PhG22/CardForge-M1/input_cartas/20260925_152937.jpg

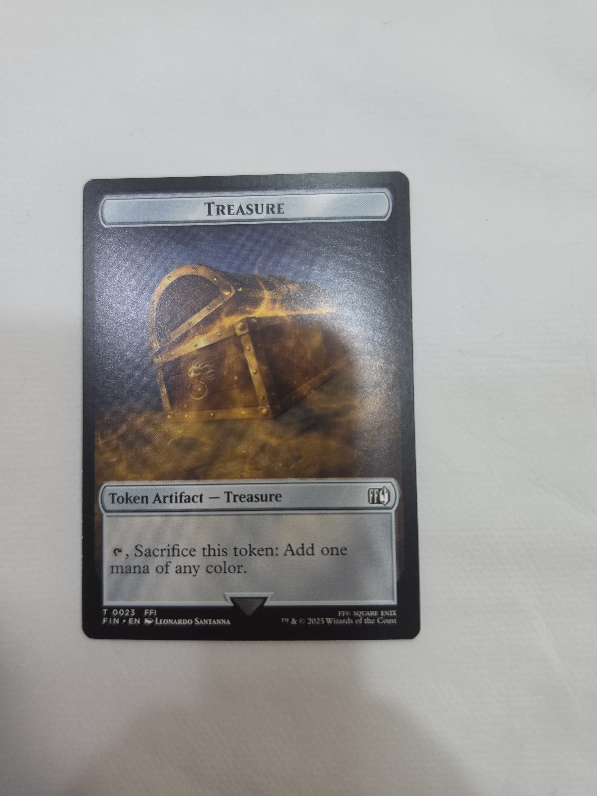
input_cartas/20260925_152937.jpg
