PhG22/CardForge-M1/input_cartas/20260925_153103.jpg

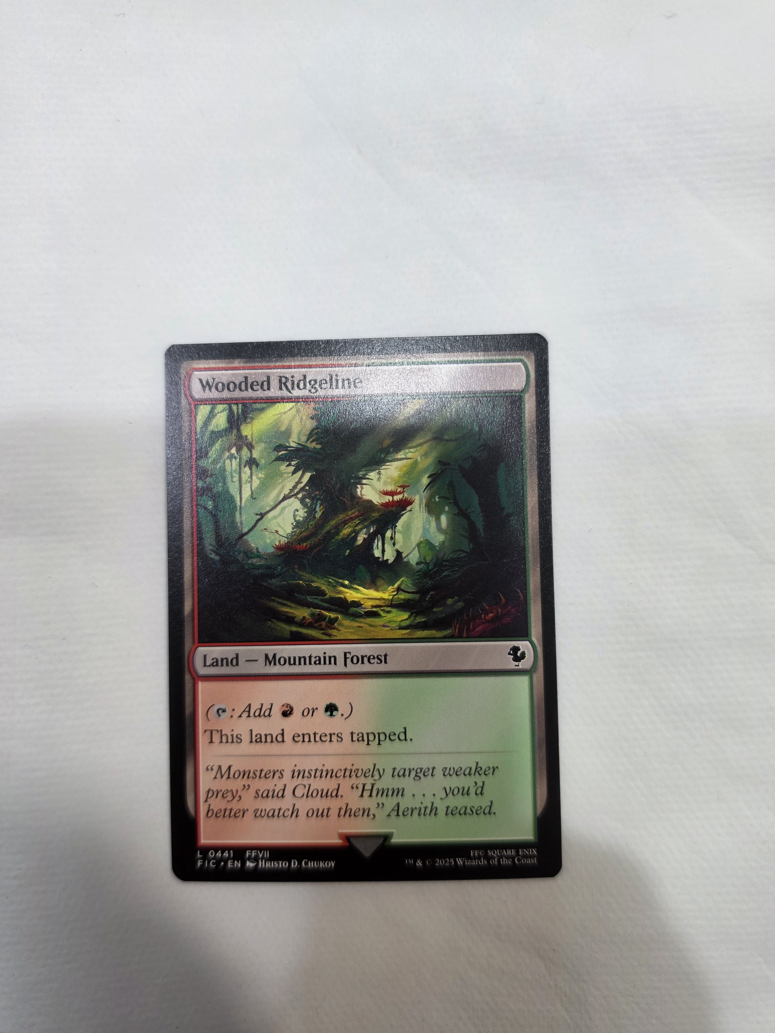
input_cartas/20260925_153103.jpg
