PhG22/CardForge-M1/input_cartas/20260925_230847.jpg

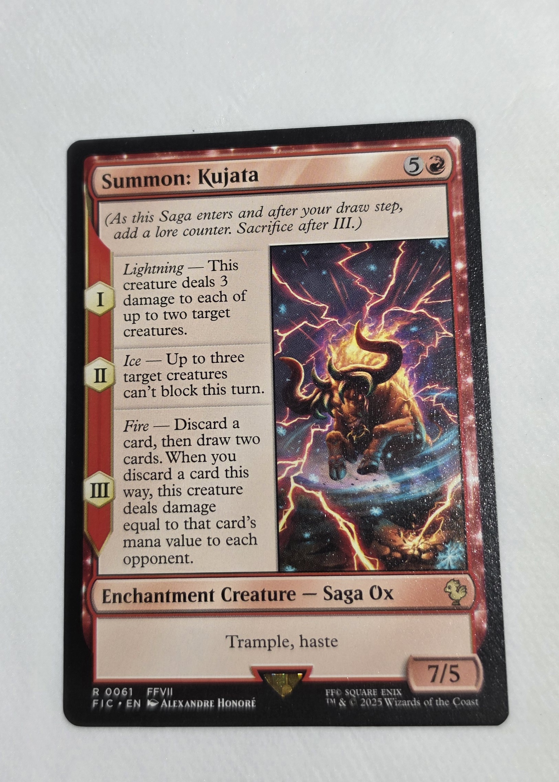
input_cartas/20260925_230847.jpg
