PhG22/CardForge-M1/input_cartas/20260927_092521.jpg

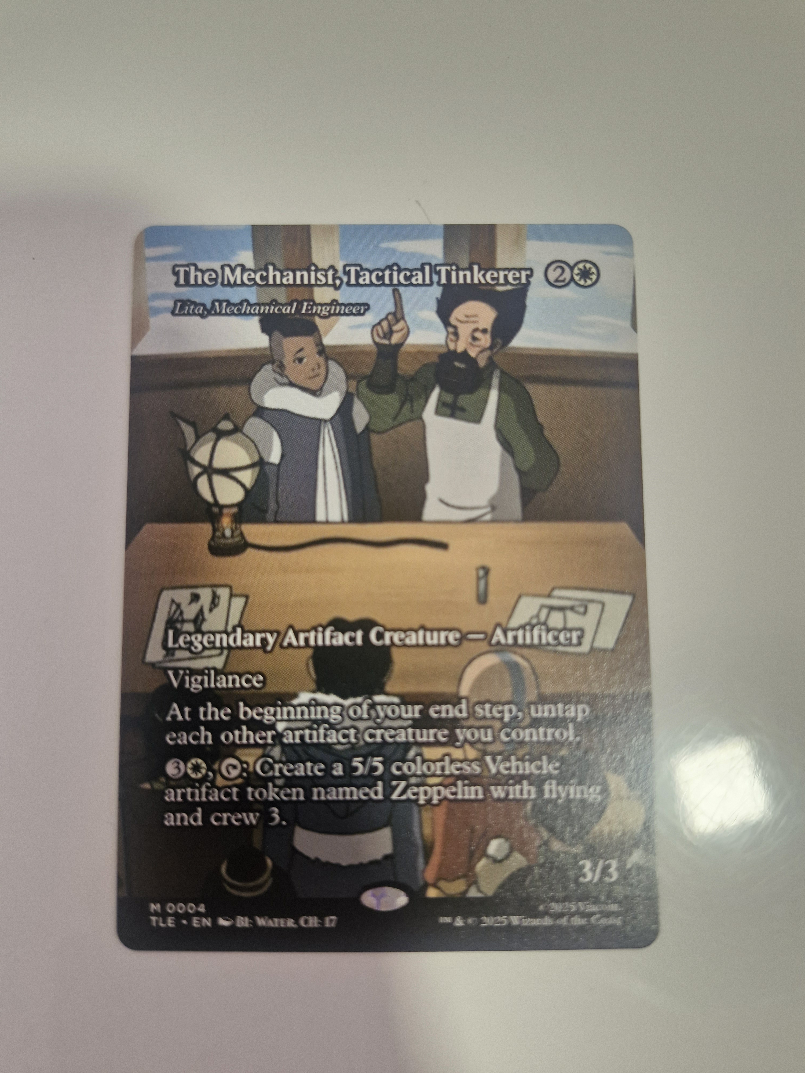
input_cartas/20260927_092521.jpg
