PhG22/CardForge-M1/relatorios/20260925_152442_processada.jpg

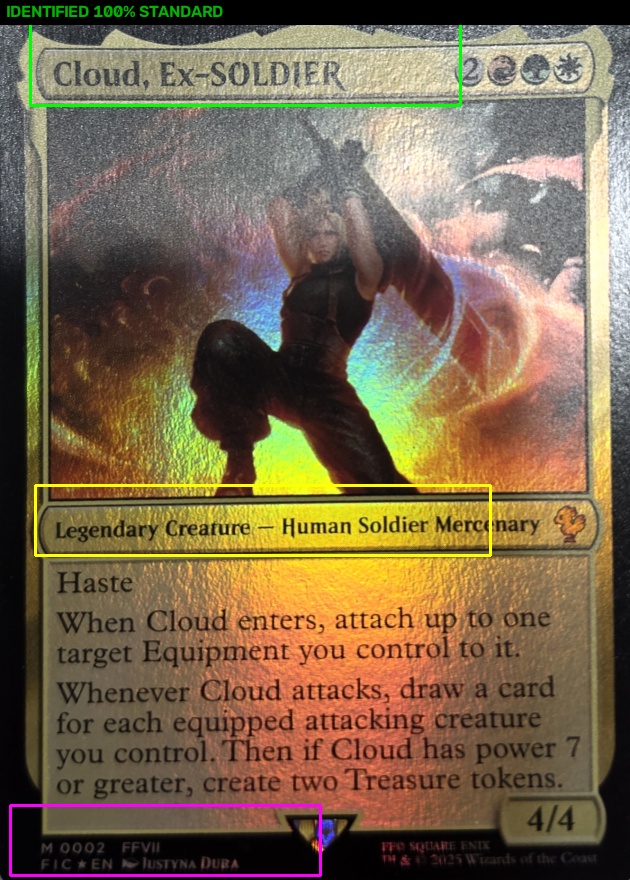
relatorios/20260925_152442_processada.jpg
