PhG22/CardForge-M1/relatorios/20260925_152524_processada.jpg

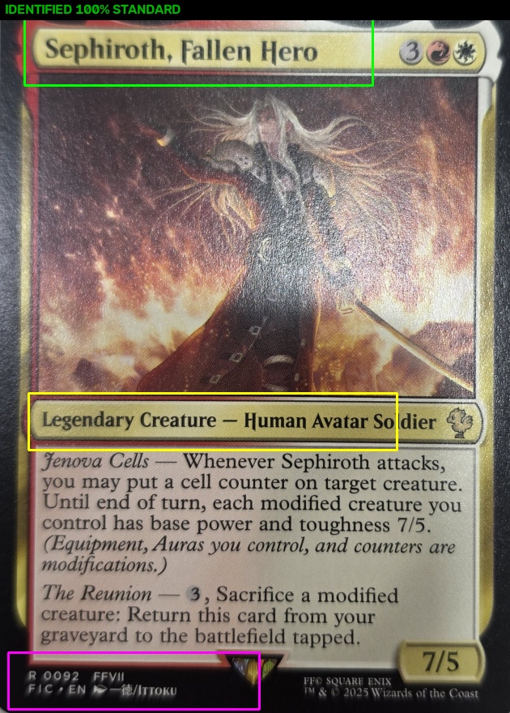
relatorios/20260925_152524_processada.jpg
