PhG22/CardForge-M1/relatorios/20260925_152959_processada.jpg

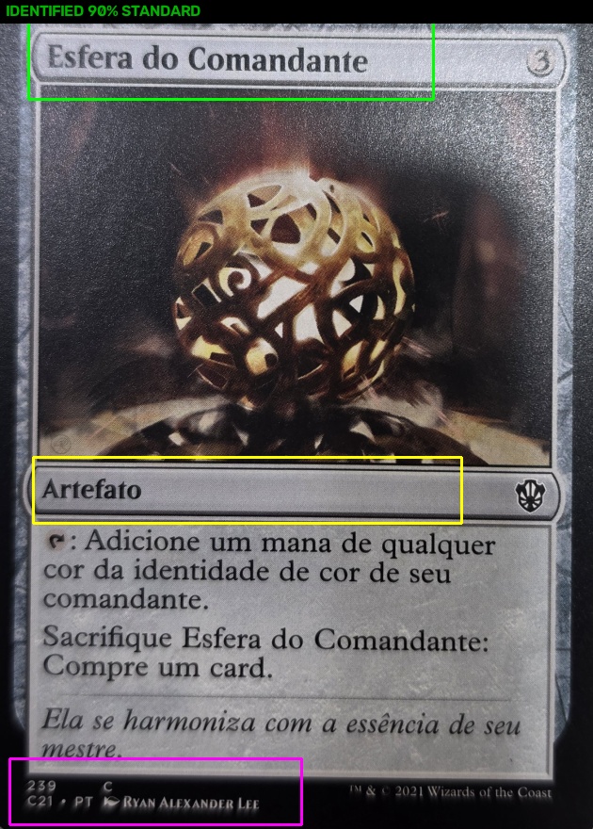
relatorios/20260925_152959_processada.jpg
