PhG22/CardForge-M1/relatorios/20260925_153542_processada.jpg

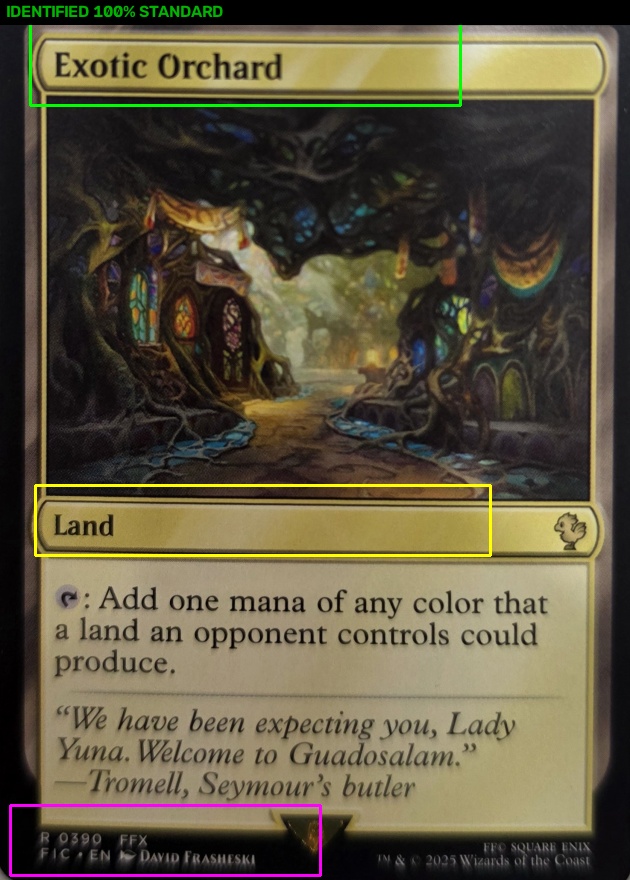
relatorios/20260925_153542_processada.jpg
