PhG22/CardForge-M1/relatorios/20260925_230528_processada.jpg

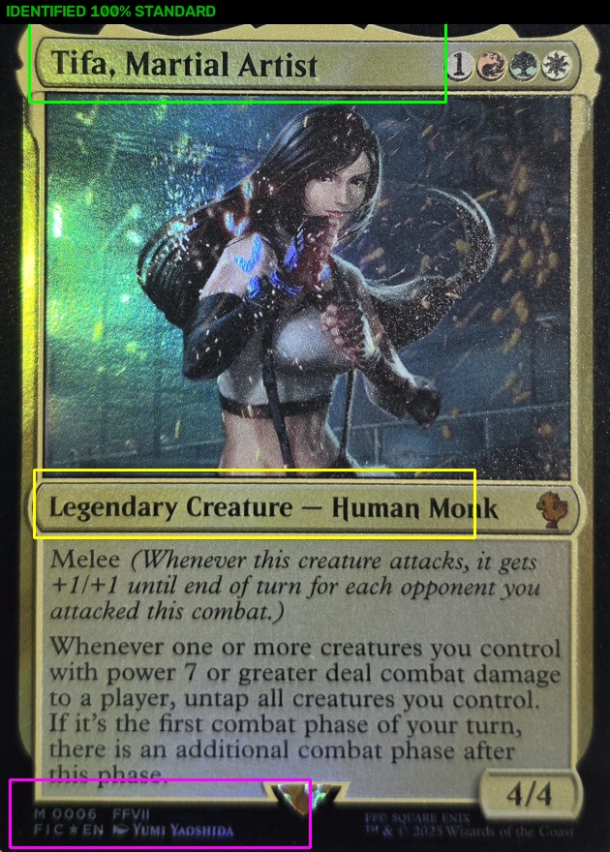
relatorios/20260925_230528_processada.jpg
