PhG22/CardForge-M1/relatorios/20260925_230637_processada.jpg

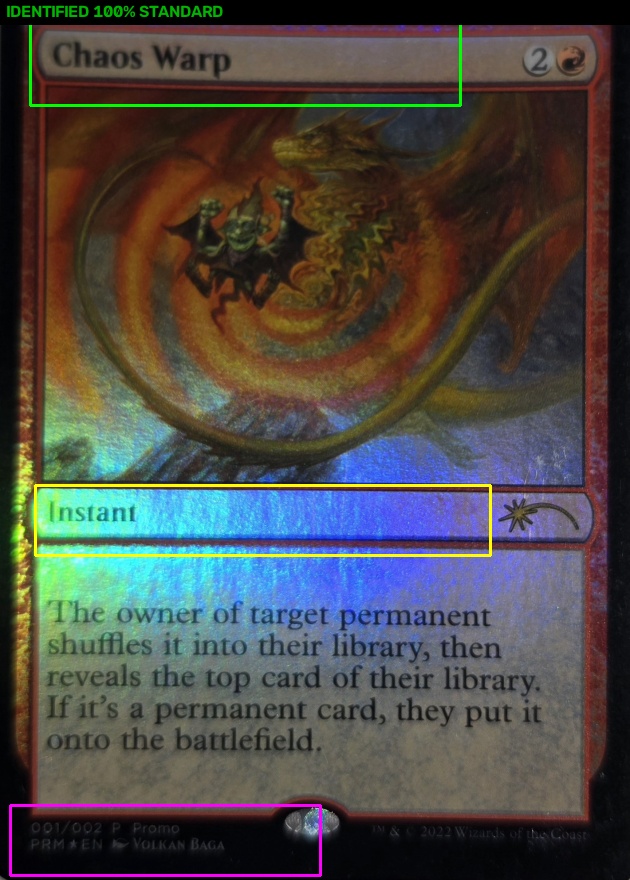
relatorios/20260925_230637_processada.jpg
