PhG22/CardForge-M1/relatorios/20260925_230715_processada.jpg

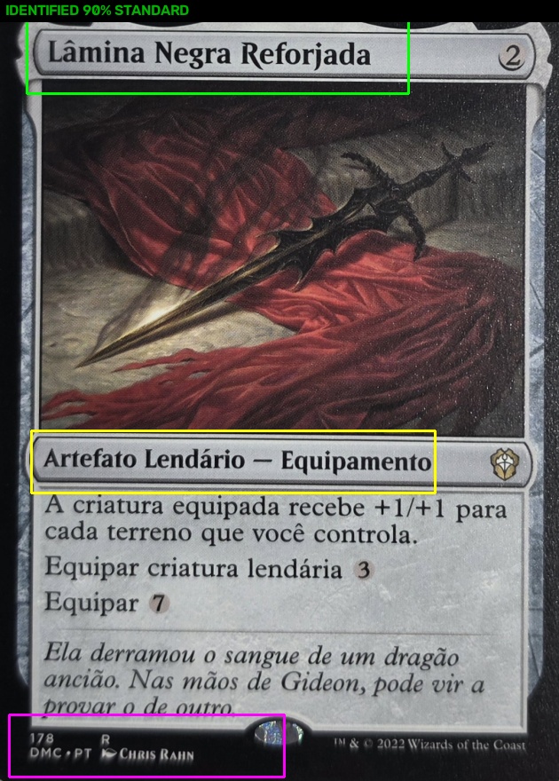
relatorios/20260925_230715_processada.jpg
