PhG22/CardForge-M1/relatorios/20260925_230815_processada.jpg

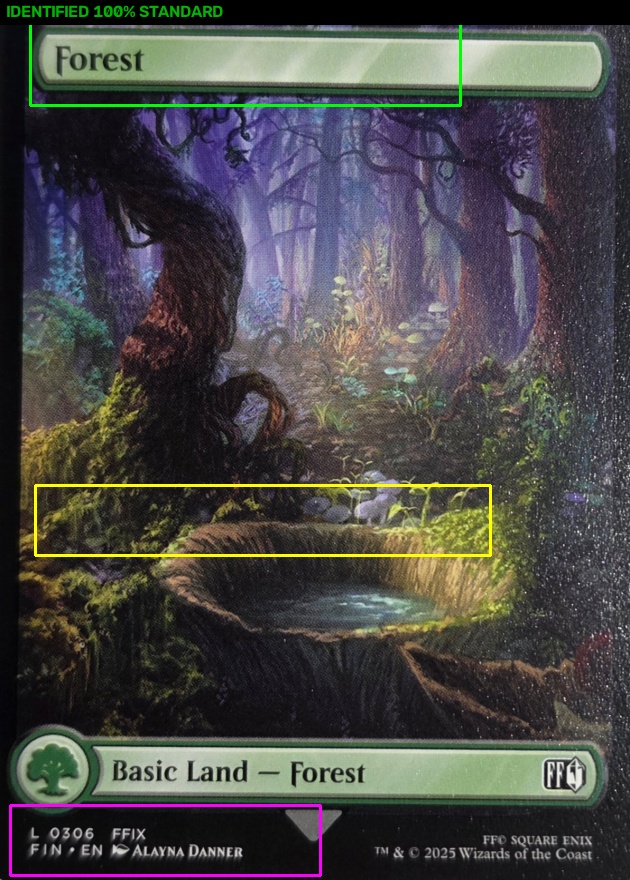
relatorios/20260925_230815_processada.jpg
