PhG22/CardForge-M1/relatorios/20260925_230847_processada.jpg

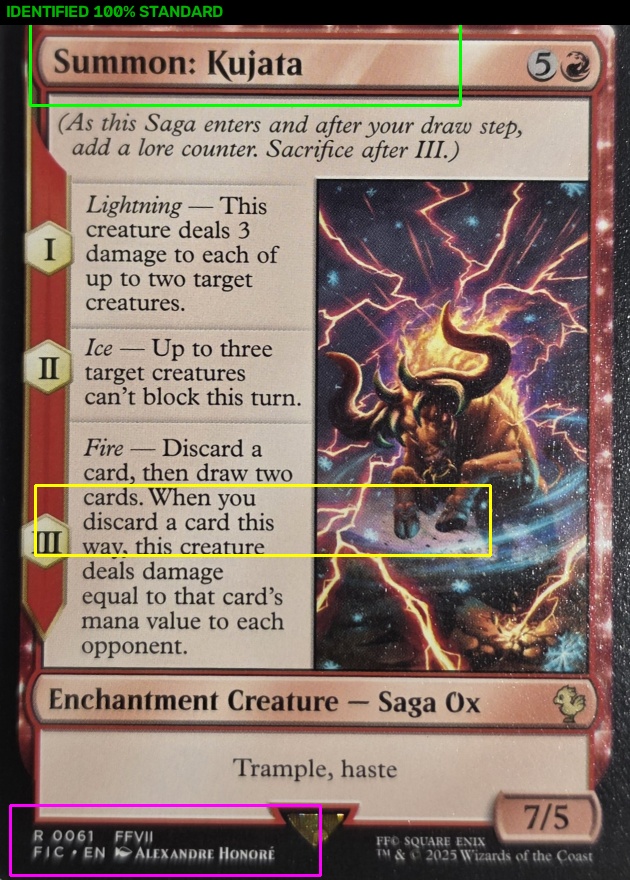
relatorios/20260925_230847_processada.jpg
