PhG22/CardForge-M1/relatorios/20260925_231020_processada.jpg

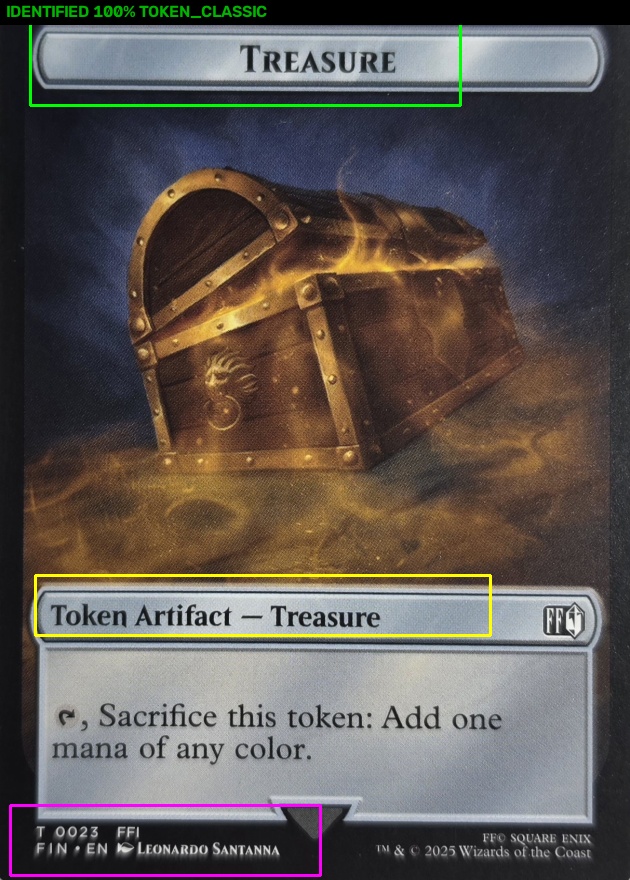
relatorios/20260925_231020_processada.jpg
