PhG22/CardForge-M1/relatorios/20260925_231043_processada.jpg

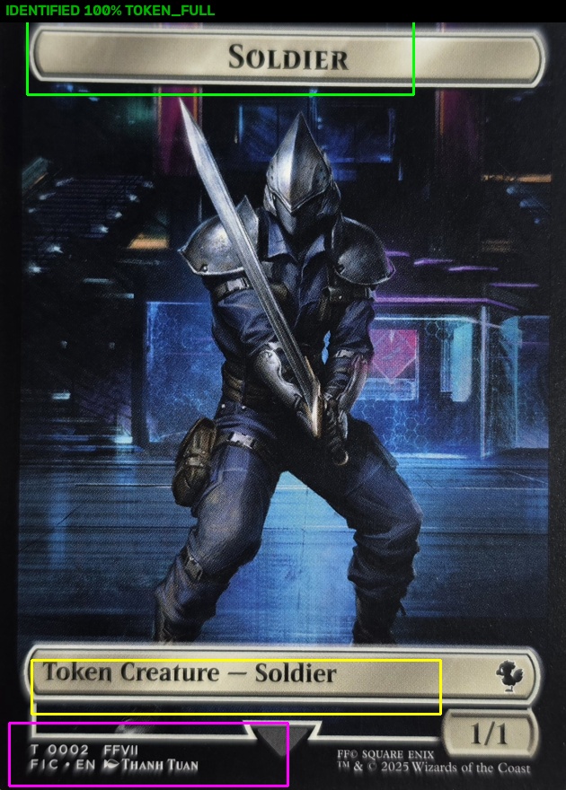
relatorios/20260925_231043_processada.jpg
