PhG22/CardForge-M1/relatorios/20260927_092518_processada.jpg

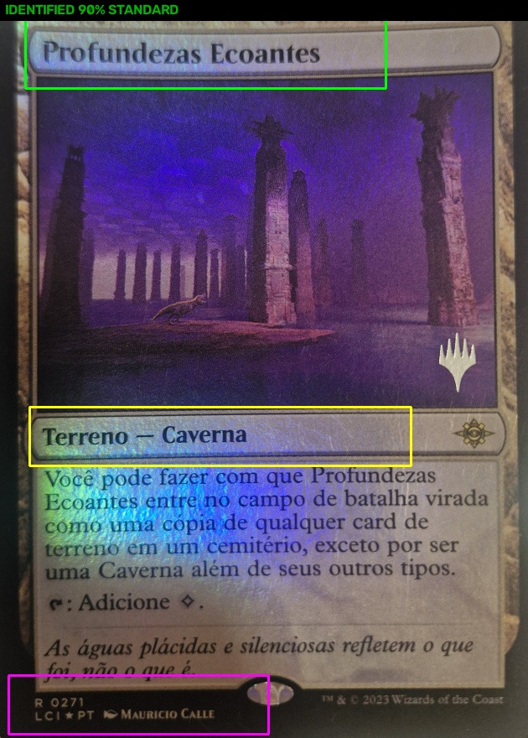
relatorios/20260927_092518_processada.jpg
