PhG22/CardForge-M1/calibragem_recorte/medicoes.csv

file | taken_at | found | strategy | corners | frame_width | frame_height
20261112_022431_334.jpg | 2026-11-12T02:24:31 | 1 | CANNY | [[0.20377, 0.3725], [0.8085, 0.34], [0.83104, 0.945], [0.20001, 0.95375]] | 1640 | 1232
20261112_022936_582.jpg | 2026-11-12T02:29:36 | 1 | CANNY | [[0.17935, 0.37], [0.81507, 0.35], [0.83385, 0.95125], [0.18593, 0.95375]] | 1640 | 1232
20261112_023028_752.jpg | 2026-11-12T02:30:28 | 1 | CANNY | [[0.20659, 0.37625], [0.80662, 0.34], [0.8301, 0.945], [0.18687, 0.95625]] | 1640 | 1232
20261112_023128_688.jpg | 2026-11-12T02:31:28 | 1 | OTSU_DARK_OPEN | [[0.20471, 0.38], [0.45167, 0.3775], [0.45918, 0.93875], [0.1878, 0.95625]] | 1640 | 1232
20261112_023209_198.jpg | 2026-11-12T02:32:09 | 1 | CANNY | [[0.20001, 0.3725], [0.80474, 0.34], [0.8301, 0.94375], [0.19626, 0.95375]] | 1640 | 1232
20261112_023339_344.jpg | 2026-11-12T02:33:39 | 1 | CANNY | [[0.17372, 0.37125], [0.8085, 0.34], [0.83198, 0.94125], [0.18593, 0.95375]] | 1640 | 1232
20261112_023410_949.jpg | 2026-11-12T02:34:10 | 1 | CANNY | [[0.20095, 0.37625], [0.80568, 0.34], [0.83385, 0.94], [0.18687, 0.96]] | 1640 | 1232
20261112_023436_276.jpg | 2026-11-12T02:34:36 | 1 | OTSU_DARK | [[0.18874, 0.3725], [0.46388, 0.3725], [0.46388, 0.95], [0.18874, 0.95]] | 1640 | 1232
20261112_023455_724.jpg | 2026-11-12T02:34:55 | 1 | OTSU_DARK | [[0.20189, 0.3725], [0.73807, 0.40875], [0.74652, 0.9375], [0.19626, 0.95125]] | 1640 | 1232
20261112_023527_295.jpg | 2026-11-12T02:35:27 | 1 | OTSU_DARK_OPEN | [[0.20565, 0.375], [0.45355, 0.37125], [0.45355, 0.95625], [0.18499, 0.95375]] | 1640 | 1232
