PhG22/CardForge-M1/relatorios/resultados.csv

file | status | confidence | method | layout | card_name | set | number | color_identity | print_id | ocr_name | ocr_type | ocr_info | ocr_set | ocr_number | elapsed_ms | verdict
20260925_152442.jpg | IDENTIFIED | 100 | SET_NUMBER | STANDARD | Cloud, Ex-SOLDIER | FIC | 2 | WRG | 07b4e4f8-6a31-4533-be51-668ce3ddc84f | Cloud,Ex-SOLDIER | Legendary CreafureHuman SoldierMerc | M0002 FFVII FIC★ENIUSTYNA DURA | FIC | 0002 | 889
20260925_152524.jpg | IDENTIFIED | 100 | SET_NUMBER | STANDARD | Sephiroth, Fallen Hero | FIC | 92 | WR | df919eb8-9eff-4777-9c46-94c795cda918 | Sephiroth,FallenHero | Legendary Creature -Human Avatar So | R0092 FFVII FIC·EN W一德/ITTOKU | FIC | 0092 | 648
20260925_152937.jpg | IDENTIFIED | 100 | SET_NUMBER | TOKEN_CLASSIC | Treasure | TFIN | 23 |  | ab0cda01-10b5-4a1b-b2bb-ad8bb296590f | TREASURE | TokenArtifact-Treasure | T0023 FFI FINEN LEONARDO SANTANNA | FIN | 0023 | 1760
20260925_152959.jpg | IDENTIFIED | 90 | SET_NUMBER_LOCALIZED | STANDARD | Commander's Sphere | C21 | 239 |  | 1c1fda5d-f519-4b27-9fc6-1a617d0fc79b | Esfera do Comandante | Artefato | 239 C21·PT RYANALEXANDERLEE | C21 | 239 | 498
20260925_153020.jpg | IDENTIFIED | 100 | SET_NUMBER | STANDARD | Tifa, Martial Artist | FIC | 6 | WRG | 31513afc-329c-4913-8fcd-945c39ec82b2 | Tifa,MartialArtist | LegendaryCreature-HumanMon | M0006 FFVII FIC*ENYUMIYAOSHIDA | FIC | 0006 | 582
20260925_153044.jpg | IDENTIFIED | 100 | SET_NUMBER | STANDARD | Bastion Protector | FIC | 233 | W | 0ed04a28-2984-4fa6-a11e-f508b7b5446e | Bastion Protector | Creature-Human Soldier | R0233 FFVII FICEN WIGNATIUSBUDI | FIC | 0233 | 502
20260925_153103.jpg | CROP_FAILED | 0 |  |  |  |  |  |  |  |  |  |  |  |  | 116
20260925_153122.jpg | IDENTIFIED | 100 | SET_NUMBER | STANDARD | Harmonize | FIC | 308 | G | 978410dd-aace-4a70-8028-6dd11c14156e | Harmonize | Sorcery | U0308 FFVII FICEN MAGALI VILLENEUVE | FIC | 0308 | 542
20260925_153154.jpg | IDENTIFIED | 100 | SET_NUMBER | STANDARD | Rugged Prairie | FIC | 417 | WR | 3d575770-cb81-4353-b49e-cdaca7a5162f | Rugged Prairie | Land | R0417 FFVII FIC.EN PABLO MENDOZA | FIC | 0417 | 497
20260925_153224.jpg | IDENTIFIED | 100 | SET_NUMBER | STANDARD | Scavenger Grounds | FIC | 419 |  | a4e3f65d-8d73-4fd1-9de4-813ba6e40940 | ScavengerGrounds | Desert | R.0419 FFXIV FICEN SALVATORREZEEYAZZIE | FIC | 0419 | 999
20260925_153246.jpg | IDENTIFIED | 100 | SET_NUMBER | STANDARD | Barret Wallace | FIN | 129 | R | 1a504dff-5857-4a61-ab99-616d5df7cf5a | BarretWallace | LegendaryCreature-Human Rel | U:0129 FFVII FINENOPATRIK HELL | FIN | 0129 | 1033
20260925_153311.jpg | IDENTIFIED | 100 | NAME_EXACT | STANDARD | Chaos Warp | MBC | 72 | R | fb8d8106-b9bd-405c-886e-72fc301c65e1 | Chaos Warp | Instant | 001/002 PPromo PRM*ENK NOLKANBAGA | PRM | 001 | 949
20260925_153333.jpg | IDENTIFIED | 100 | SET_NUMBER | STANDARD | Command Tower | FIC | 485 |  | aae0b3ae-ed57-4d17-8876-736aa22186cf | Command Tower | Land | C0485 FICENER | FIC | 0485 | 409
20260925_153353.jpg | IDENTIFIED | 100 | SET_NUMBER | STANDARD | Zack Fair | FIN | 45 | W | f21f9161-5945-40da-8da0-446f6a4a1c23 | ZackFain | Legendary Creature-Human Sole | U0045 FFVU FINEN 杉浦善夫/OSHIOSUGIURA | FIN | 0045 | 579
20260925_153422.jpg | IDENTIFIED | 100 | NAME_EXACT | STANDARD | Secret Rendezvous | FIC | 219 | W | 1fed38d0-c32c-440c-9d99-ca3b48a34791 | Secret Rendezvous | Sorcery | FIC·EN藤木幼/YUUFUKA | FIC | UNKNOWN | 376
20260925_153438.jpg | CROP_FAILED | 0 |  |  |  |  |  |  |  |  |  |  |  |  | 87
20260925_153457.jpg | IDENTIFIED | 90 | SET_NUMBER_LOCALIZED | STANDARD | Blackblade Reforged | DMC | 178 |  | 240448cd-c308-49ae-9e4b-0c35adc59fba | Lamina Negra Reforjada | Artefato Lendario-Equipamento | 178 DMC·PT WCHRISRAHN | DMC | 178 | 544
20260925_153518.jpg | IDENTIFIED | 100 | SET_NUMBER | STANDARD | Plains | FIN | 295 | W | e623b058-76d2-476b-9ee6-82807f7992c3 | Plains |  | L0295 FFVI FINEN JONASDERO | FIN | 0295 | 359
20260925_153542.jpg | IDENTIFIED | 100 | SET_NUMBER | STANDARD | Exotic Orchard | FIC | 390 |  | 47c2b572-b54a-444c-8d74-b005e94d751f | ExoticOrchard | Land | R0390 FFX FICIEN DAYID FRASHESKI | FIC | 0390 | 482
20260925_153603.jpg | CROP_FAILED | 0 |  |  |  |  |  |  |  |  |  |  |  |  | 109
20260925_153619.jpg | IDENTIFIED | 100 | NAME_EXACT | FULL_ART | Forest | FIN | 576 | G | 2036f825-ef57-4a40-b45f-0668d9c8ec6a | Forest | BasicLand-Forest | L9306 FIN.EN FFIX ALAYNADANNER | FIN | 9306 | 1091
20260925_153644.jpg | CROP_FAILED | 0 |  |  |  |  |  |  |  |  |  |  |  |  | 110
20260925_153646.jpg | IDENTIFIED | 90 | SET_NUMBER_LOCALIZED | STANDARD | Summon: Kujata | FIC | 61 | R | ba934866-efd0-4126-b1ff-9c7e82b73bd6 | fter Sum and aj Sacrifice af thisSaga enters unter | cards. discard a card this waythiscreature | R0061 FFVI HONORE FICEN ALEXANDRE | FIC | 0061 | 656
20260925_153715.jpg | IDENTIFIED | 100 | SET_NUMBER | STANDARD | Rootbound Crag | FIC | 416 | RG | 73a2e070-f375-4558-a982-01f6f4e902e9 | Rootbound Crag | Land | R0416 FIC AEN | FIC | 0416 | 379
20260925_153807.jpg | IDENTIFIED | 100 | SET_NUMBER | STANDARD | Secret Rendezvous | FIC | 253 | W | d09a77e7-649c-4f2c-bcd3-0598271e9373 | Secret Rendezvous | Sorcery | U0253 FFVII FIC·EN 藤木/YUFkI | FIC | 0253 | 525
20260925_153819.jpg | IDENTIFIED | 90 | SET_NUMBER_LOCALIZED | STANDARD | Commander's Sphere | C21 | 239 |  | 1c1fda5d-f519-4b27-9fc6-1a617d0fc79b | Esfera do Comandante | Artefato | 239 C21·PT RYANALEXANDERLEE | C21 | 239 | 509
20260925_153835.jpg | IDENTIFIED | 100 | SET_NUMBER | STANDARD | Sephiroth, Fallen Hero | FIC | 92 | WR | df919eb8-9eff-4777-9c46-94c795cda918 | Sephiroth,FallenHero | LegendaryCreature-HumanAvatarSo | R0092 FFVII FIC·EN | FIC | 0092 | 699
20260925_153854.jpg | IDENTIFIED | 100 | SET_NUMBER | STANDARD | Cloud, Ex-SOLDIER | FIC | 2 | WRG | 07b4e4f8-6a31-4533-be51-668ce3ddc84f | Cloud,Ex-SOLDIER | LegendaryCreature-Human Soldier Merce | M0002 FFVII FICENWIUSTYNADURA | FIC | 0002 | 678
20260925_230006.jpg | IDENTIFIED | 100 | SET_NUMBER | STANDARD | Cloud, Ex-SOLDIER | FIC | 2 | WRG | 07b4e4f8-6a31-4533-be51-668ce3ddc84f | Cloud,Ex-SOLDIER | Legendary Creature-Human Soldier Merce | M0002 FFVII FIC★ENIUSTYNADURA | FIC | 0002 | 649
20260925_230528.jpg | IDENTIFIED | 100 | SET_NUMBER | STANDARD | Tifa, Martial Artist | FIC | 6 | WRG | 31513afc-329c-4913-8fcd-945c39ec82b2 | Tifa,MartialArtist | Legendary Creature -Human Mon | M0006 FFVII FIC★EN DYUMIYAOSHIDA | FIC | 0006 | 633
20260925_230601.jpg | IDENTIFIED | 90 | SET_NUMBER_LOCALIZED | STANDARD | Commander's Sphere | C21 | 239 |  | 1c1fda5d-f519-4b27-9fc6-1a617d0fc79b | Esfera do Comandante | Artefato | 239 C21.PTD RYANALEXANDERLEE | C21 | 239 | 484
20260925_230637.jpg | IDENTIFIED | 100 | NAME_EXACT | STANDARD | Chaos Warp | MBC | 72 | R | fb8d8106-b9bd-405c-886e-72fc301c65e1 | Chaos Warp | Instant | 001/002P Promo PRM*ENVOLKANBAGA | PRM | 001 | 1048
20260925_230715.jpg | IDENTIFIED | 90 | SET_NUMBER_LOCALIZED | STANDARD | Blackblade Reforged | DMC | 178 |  | 240448cd-c308-49ae-9e4b-0c35adc59fba | Lamina Negra Reforjada | Artefato Lendario -Equipamento | 178 DMC·PT WCHRISRAHN | DMC | 178 | 640
20260925_230748.jpg | IDENTIFIED | 100 | SET_NUMBER | STANDARD | Ultimate Magic: Meteor | FIC | 121 | R | 809276a9-4804-422f-abb0-ba302f329e6e | Ultimate Magic:Meteor | Sorcery | RO121 FFVII FICENASHLEYMACKENZIE | FIC | 121 | 570
20260925_230815.jpg | IDENTIFIED | 100 | SET_NUMBER | STANDARD | Forest | FIN | 306 | G | be72862d-d71e-4b18-98a6-59019399f631 | Forest |  | L0306 FFIX FINEN ALAYNADANNER | FIN | 0306 | 482
20260925_230847.jpg | IDENTIFIED | 100 | SET_NUMBER | STANDARD | Summon: Kujata | FIC | 61 | R | ba934866-efd0-4126-b1ff-9c7e82b73bd6 | Summon:Kujata | cards.When you discard a card this way,this creature | R0061 FFVII FICEN WALEXANDRE HONORE | FIC | 0061 | 636
20260925_230912.jpg | IDENTIFIED | 100 | SET_NUMBER | STANDARD | Sephiroth, Fallen Hero | FIC | 92 | WR | df919eb8-9eff-4777-9c46-94c795cda918 | Sephiroth,Fallen Hero | LegendaryCreature-Human Avatar So | R0092 FFVII FICIEN 德/ITTOKU | FIC | 0092 | 370
20260925_230944.jpg | IDENTIFIED | 100 | SET_NUMBER | TOKEN_FULL | Rebel | TFIC | 7 | R | 6afbbdad-aeed-428a-b840-c33f59a18d0b | REBEL | Token Creature-Rebel | T0007 FFVII FIC·EN ANTHONY DEVINE | FIC | 0007 | 1126
20260925_230956.jpg | IDENTIFIED | 100 | SET_NUMBER | TOKEN_FULL | Rebel | TFIC | 7 | R | 6afbbdad-aeed-428a-b840-c33f59a18d0b | REBEL | Token Creature-Rebel | T 0007 FFVII FIC·EN ANTHONY DEVINE | FIC | 0007 | 1101
20260925_231020.jpg | IDENTIFIED | 100 | SET_NUMBER | TOKEN_CLASSIC | Treasure | TFIN | 23 |  | ab0cda01-10b5-4a1b-b2bb-ad8bb296590f | TREASURE | TokenArtifact-Treasure | T0023 FFI FIN·EN LEONARDO SANTANNA | FIN | 0023 | 1426
20260925_231043.jpg | IDENTIFIED | 100 | SET_NUMBER | TOKEN_FULL | Soldier | TFIC | 2 | W | c459f2ec-2aa3-44f6-999f-b1467dd4e27c | SOLDIER | Token Creature-Soldier | T0002 FFVII FIC·EN THANHTUAN | FIC | 0002 | 1174
20260927_092411.jpg | LOW_CONFIDENCE | 89 | SET_NUMBER_NAME_MISMATCH | STANDARD | Cloudpiercer | IKO | 291 | R | 3db7d906-1794-40eb-9d73-1f2a4db3a13f | Furanuvem |  | 291 IKO·PT STEVEELLIS | IKO | 291 | 930
20260927_092415.jpg | IDENTIFIED | 90 | SET_NUMBER_LOCALIZED | STANDARD | Prickly Marmoset | IKO | 129 | R | bad8512f-31b9-48ba-bb10-1497303dcfba | Sagui Espinhoso | Criatura-Macaco | 129/274 IKOPT SIMONDOMINIC | IKO | 129 | 507
20260927_092417.jpg | IDENTIFIED | 90 | SET_NUMBER_LOCALIZED | STANDARD | Echoing Deeps | LCI | 271 |  | 244c06b3-532d-426e-8bee-ee9461d092a6 | Profundezas Ecoantes | Terreno-Caverna | R0271 LCI*PT OMAURICIOCALLE | LCI | 0271 | 466
20260927_092422.jpg | IDENTIFIED | 94 | SET_NUMBER | STANDARD | Lita, Mechanical Engineer | TLE | 4 | W | e9211079-9499-4443-8cb9-4c2bb2849994 | TheMechanist,TacticalTinke | LegendaryArtifact Creature-Arti | M0004 TLEENBI:WATER,CH:17 | TLE | 0004 | 468
20260927_092425.jpg | IDENTIFIED | 100 | SET_NUMBER | STANDARD | Lasyd Prowler | TDM | 149 | G | c7f5c8ef-8e9e-4264-a7d2-126a30a5d341 | Lasyd Prowler | Creature-Snake Ranger | R0149 TDM·EN ANNAPAVLEEVA | TDM | 0149 | 465
20260927_092427.jpg | IDENTIFIED | 90 | SET_NUMBER_LOCALIZED | STANDARD | Plains | MOM | 277 | W | 00bf269d-aca3-494c-8777-de90ae903af2 | Planicie | Terreno Basico-Planicie | L0277 MOM★PTSAMBURLEY | MOM | 0277 | 445
20260927_092429.jpg | IDENTIFIED | 100 | NAME_EXACT | STANDARD | Island | MDD | 294 | U | 1335d293-3dd2-4f13-bd2c-22181f4528ee | Island | BasicLand-Island | -JonasDeRo rv&2013WizardsoftheCoast236/249 | N/A | 236 | 519
20260927_092432.jpg | IDENTIFIED | 100 | SET_NUMBER | STANDARD | Forest | BRO | 287 | G | c1c2a41c-e974-4c14-8d01-d278ecdb31bc | Floresta |  | 287/287L BRO.PTPIOTRDUBA | BRO | 287 | 369
20260927_092434.jpg | IDENTIFIED | 100 | NAME_EXACT | STANDARD | Sakura-Tribe Elder | SOC | 285 | G | 7a8b1c49-8594-426d-b585-41140235bb0e | Sakura-Tribe Elder |  | P oooi Promo PRMEN VICTORADAMEMINGUEZ | PRM | UNKNOWN | 473
20260927_092436.jpg | IDENTIFIED | 90 | SET_NUMBER_LOCALIZED | STANDARD | Glowstone Recluse | IKO | 156 | G | 06a9698d-400c-4c31-82cd-28d0897fe28c | Aranha-violino do Lumino | CriaturaAranha | 156/274U JKOPT KYIONG-HAO HAN | IKO | 156 | 767
20260927_092438.jpg | IDENTIFIED | 100 | SET_NUMBER | STANDARD | Moonshae Pixie // Pixie Dust | CLB | 84 | U | 63780e4a-3f63-473c-97d0-5d9462e264f2 | MoonshaePixie | Creature-Faerie | 084/361U CLB·EN EDGAR SANCHEZ HIDALGO | CLB | 084 | 498
20260927_092444.jpg | IDENTIFIED | 100 | SET_NUMBER | STANDARD | Moonshae Pixie // Pixie Dust | CLB | 84 | U | 63780e4a-3f63-473c-97d0-5d9462e264f2 | Moonshae Pixie | Creature-Faerie | 084/361U CLBEN EDGAR SANCHEZ HIDALGO | CLB | 084 | 521
20260927_092447.jpg | IDENTIFIED | 100 | NAME_EXACT | STANDARD | Sakura-Tribe Elder | SOC | 285 | G | 7a8b1c49-8594-426d-b585-41140235bb0e | Sakura-TribeElder |  | P0001 Promo PRM★EN VICTORADAMEMINGUEZ | PRM | 0001 | 710
20260927_092449.jpg | IDENTIFIED | 100 | SET_NUMBER | STANDARD | Forest | BRO | 287 | G | c1c2a41c-e974-4c14-8d01-d278ecdb31bc | Floresta |  | 287/287L BRO'PT PIOTR DURA | BRO | 287 | 377
20260927_092451.jpg | LOW_CONFIDENCE | 0 | NONE | STANDARD |  |  |  |  |  | narc Toda Alcar | frer |  | N/A | UNKNOWN | 839
20260927_092458.jpg | LOW_CONFIDENCE | 89 | SET_NUMBER_NAME_MISMATCH | STANDARD | Cloudpiercer | IKO | 291 | R | 3db7d906-1794-40eb-9d73-1f2a4db3a13f | Furanuvem |  | 291 IKO·PT OSTEVEELLIS | IKO | 291 | 982
20260927_092508.jpg | IDENTIFIED | 100 | NAME_EXACT | STANDARD | Island | MDD | 294 | U | 1335d293-3dd2-4f13-bd2c-22181f4528ee | Island | BasicLand-Island | JonasDeRo m&2013WizardsoftheCoast236/249 | N/A | 236 | 541
20260927_092511.jpg | IDENTIFIED | 90 | SET_NUMBER_LOCALIZED | STANDARD | Plains | MOM | 277 | W | 00bf269d-aca3-494c-8777-de90ae903af2 | Planicie | Terreno Basico -Planicie | L0277 MOM★PTOSAMBURLEY | MOM | 0277 | 446
20260927_092513.jpg | IDENTIFIED | 100 | SET_NUMBER | STANDARD | Lasyd Prowler | TDM | 149 | G | c7f5c8ef-8e9e-4264-a7d2-126a30a5d341 | LasydProwler | Creature-Snake Ranger | R0149 TDM·EN ICANNAPAVLEEVA | TDM | 0149 | 468
20260927_092516.jpg | IDENTIFIED | 90 | SET_NUMBER_LOCALIZED | STANDARD | Prickly Marmoset | IKO | 129 | R | bad8512f-31b9-48ba-bb10-1497303dcfba | Sagui Espinhoso | Criatura-Macaco | 129/274C IKO·PT OSIMONDOMINIC | IKO | 129 | 456
20260927_092518.jpg | IDENTIFIED | 90 | SET_NUMBER_LOCALIZED | STANDARD | Echoing Deeps | LCI | 271 |  | 244c06b3-532d-426e-8bee-ee9461d092a6 | ProfundezasEcoantes | Terreno-Caverna | R0271 LCI★PT MAURICIOCALLE | LCI | 0271 | 467
20260927_092521.jpg | IDENTIFIED | 100 | SET_NUMBER | STANDARD | Lita, Mechanical Engineer | TLE | 4 | W | e9211079-9499-4443-8cb9-4c2bb2849994 |  | scnuaryArtifactCreature-A Vigilance | M0004 TLEENBI:WATERCHIZ | TLE | 0004 | 281
