PhG22/CardForge-M1/calibragem_recorte/20261112_022431_334.jpg

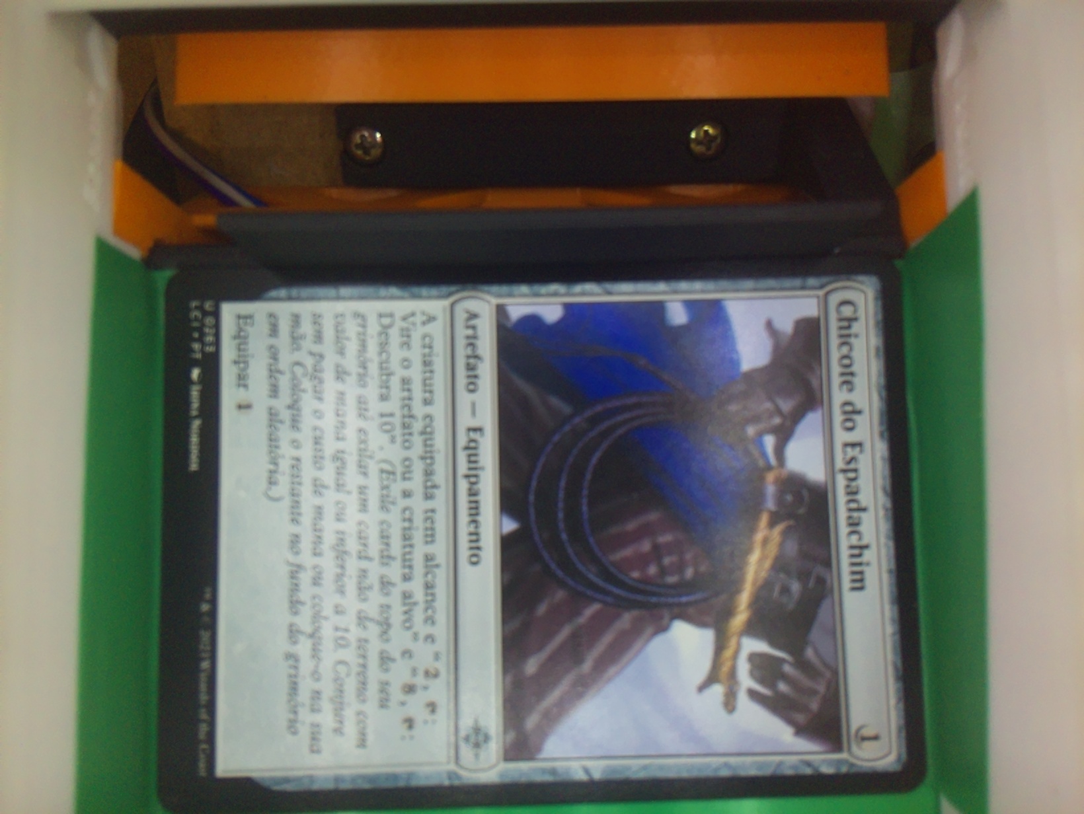
calibragem_recorte/20261112_022431_334.jpg
