PhG22/CardForge-M1/calibragem_recorte/20261112_022936_582.jpg

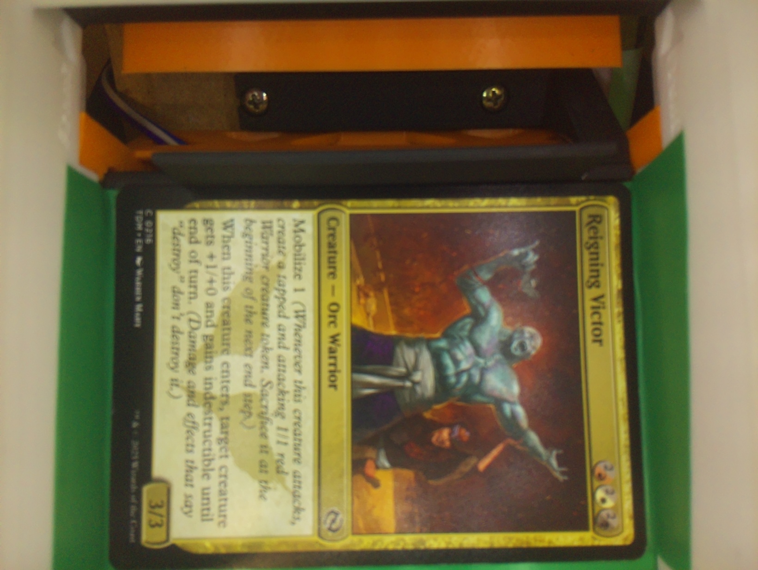
calibragem_recorte/20261112_022936_582.jpg
