PhG22/CardForge-M1/calibragem_recorte/20261112_023028_752.jpg

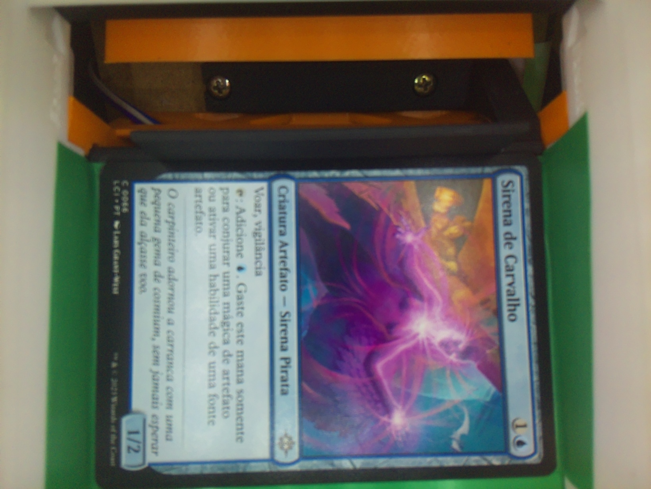
calibragem_recorte/20261112_023028_752.jpg
