PhG22/CardForge-M1/calibragem_recorte/20261112_023128_688.jpg

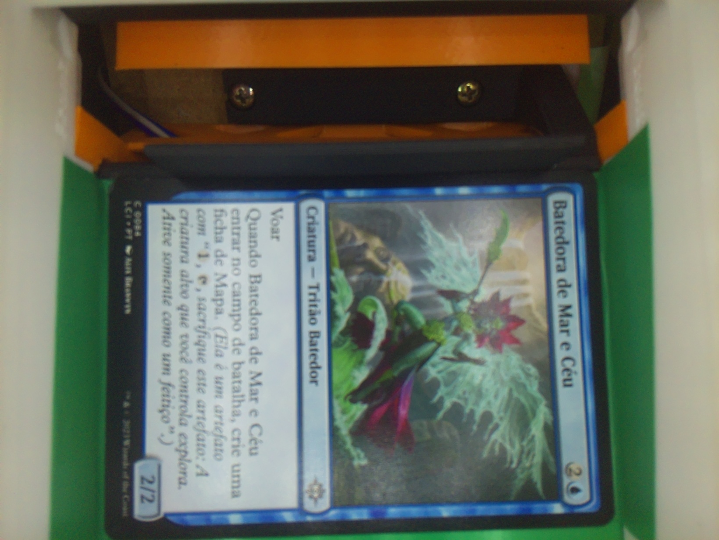
calibragem_recorte/20261112_023128_688.jpg
