PhG22/CardForge-M1/calibragem_recorte/20261112_023209_198.jpg

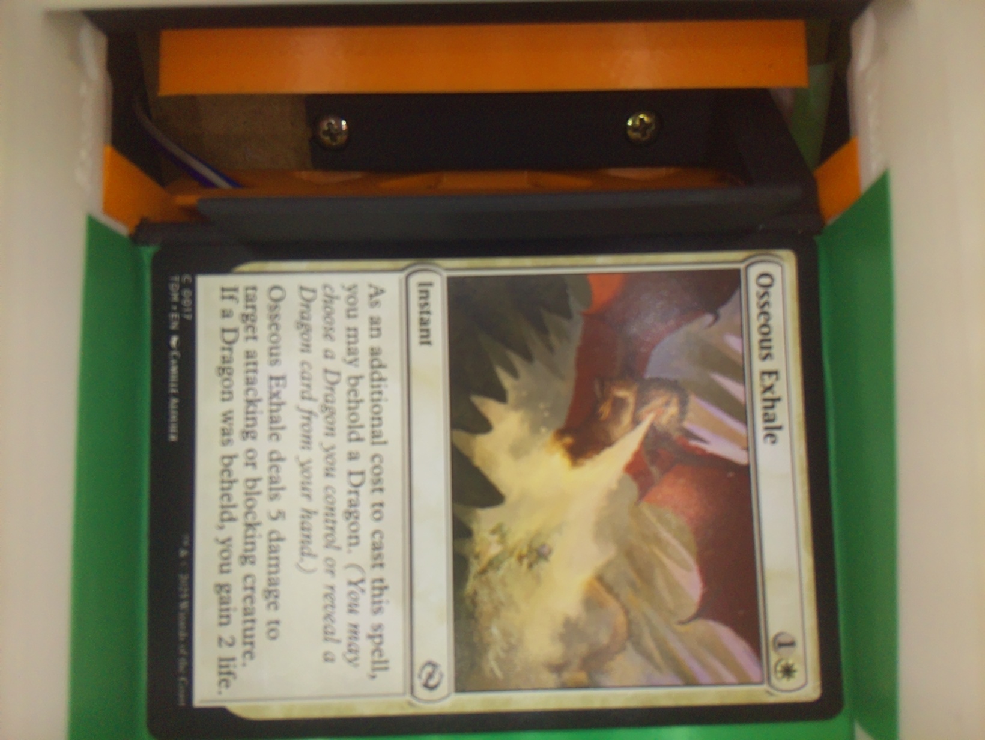
calibragem_recorte/20261112_023209_198.jpg
