PhG22/CardForge-M1/calibragem_recorte/20261112_023410_949.jpg

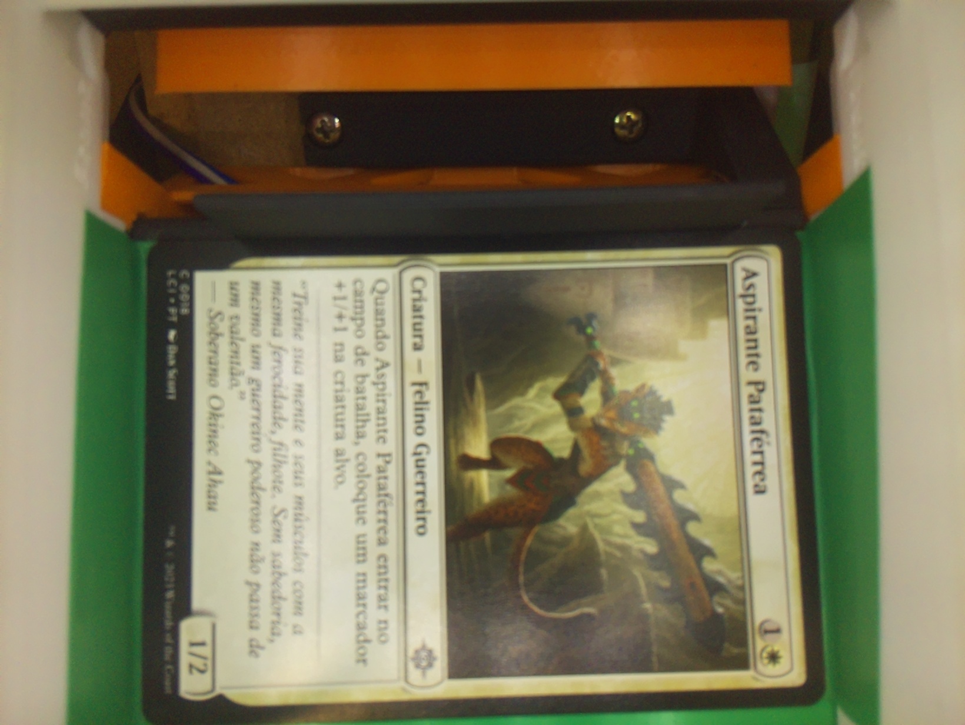
calibragem_recorte/20261112_023410_949.jpg
