PhG22/CardForge-M1/calibragem_recorte/20261112_023436_276.jpg

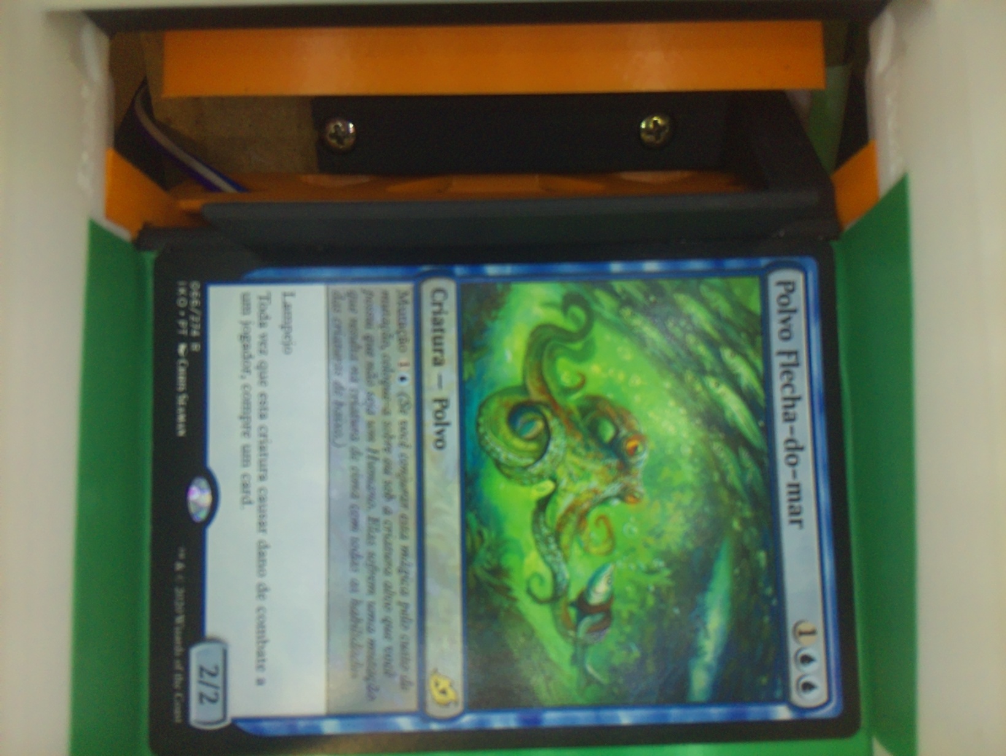
calibragem_recorte/20261112_023436_276.jpg
