PhG22/CardForge-M1/calibragem_recorte/20261112_023455_724.jpg

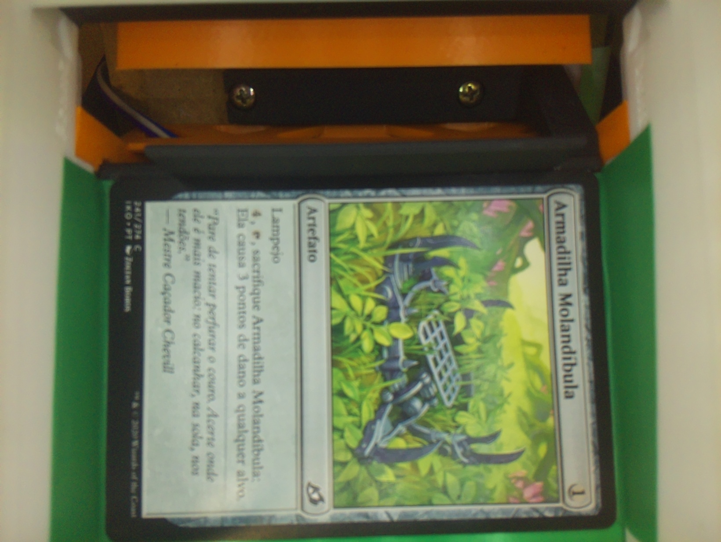
calibragem_recorte/20261112_023455_724.jpg
