PhG22/CardForge-M1/calibragem_recorte/20261112_023527_295.jpg

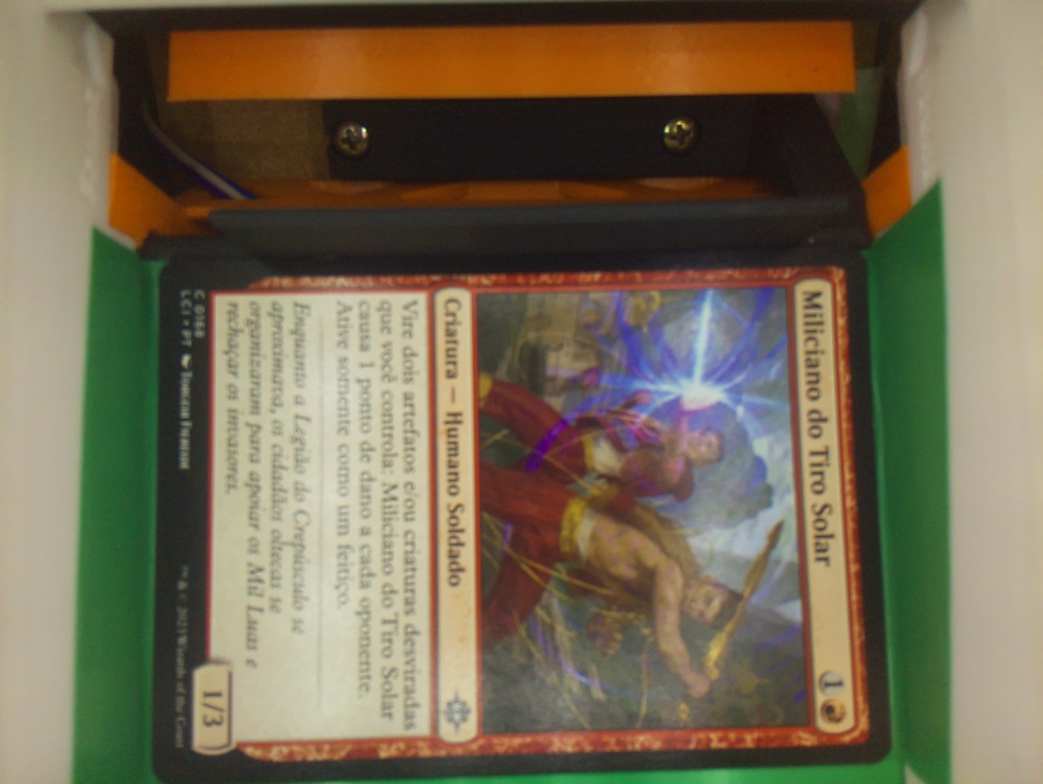
calibragem_recorte/20261112_023527_295.jpg
