PhG22/CardForge-M1/(commit log)

2026-11-07 Integra firmware, API de controle, visão computacional e app no main loop do Pi
    - sorter_api/: API de controle trazida para o repositório e estendida com o main loop
    completo: identificação por visão (até 3 capturas, RF29), bin pela identidade de cor
    (RF20), bin 6 para não identificadas/viradas (RF25/RF39), run.db com um registro por
    carta (RF19, RNF19/RNF20), pausa em falha mecânica + Resume (RNF23), limite de 250
    cartas (RNF27), eventos sem identidade durante a run (RF23), resultados e CSV
    (RF22/RF24) e as rotas que o app mobile já usa (login, /cards, /machines/...).
    - Calibração da câmera pela rede (/calibration) com a máquina montada: ajuste ao vivo,
    autocalibra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
2026-11-11 Added Status LED Control, Bin IR sensors checks, fixed cutouts for CV and Temp Files Cleanup on run end
    [__main__.py, a2_base.ino, api.py, calibration_api.py, camera.py]
2026-11-12 PostgreSQL server, run upload, sign-up, run history, CSV export, Resume, fault alerts, power-on homing
2026-11-12 RF38 notifications, RF05 pull attempts, RF08 fast homing, RNF10 retransmissions, run timing
2026-11-12 imagens do pedro
    [medicoes.csv]
