PhG22/CardForge-M1/input_cartas/20260927_092449.jpg

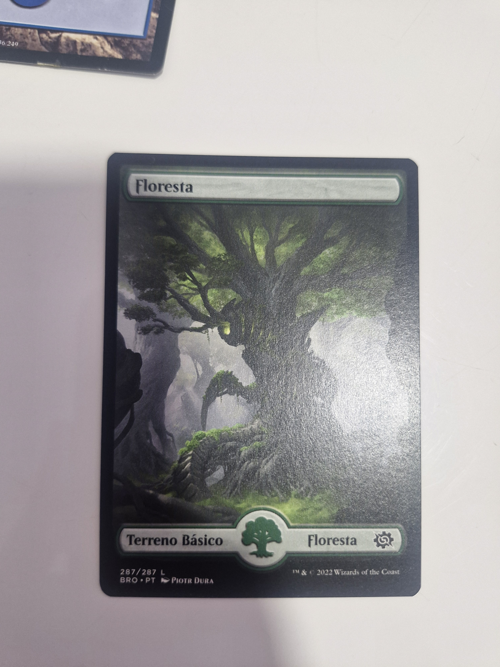
input_cartas/20260927_092449.jpg
